UMassIonTrappers/PyOpticL/Designs/modules/scalable_rb_sas/models/rb_cell_holder/rb_cell_holder.stl

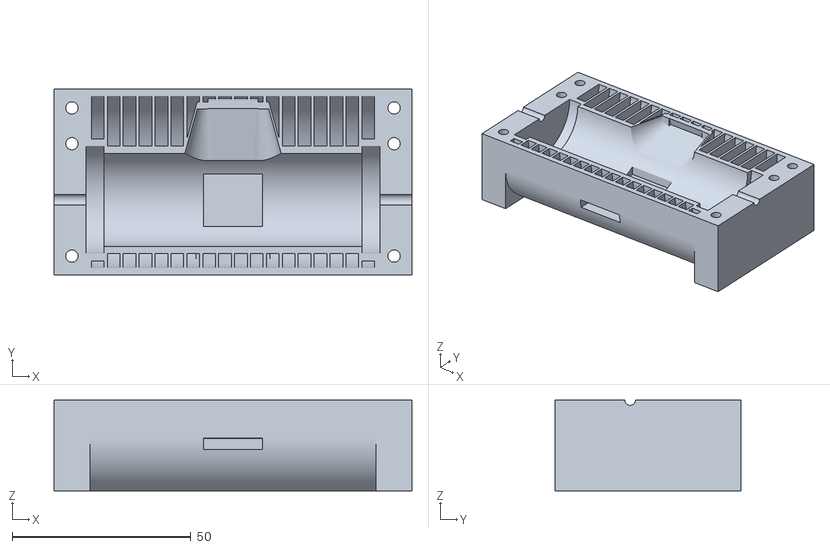
[picture p1: CAD file, 2023-10-21]
Designs/modules/scalable_rb_sas/models/rb_cell_holder/rb_cell_holder.stl
100.0 x 52.0 x 25.4
