UMassIonTrappers/PyOpticL/PyOpticL/models/io-3d-405-pbs/io-3d-405-pbs.step

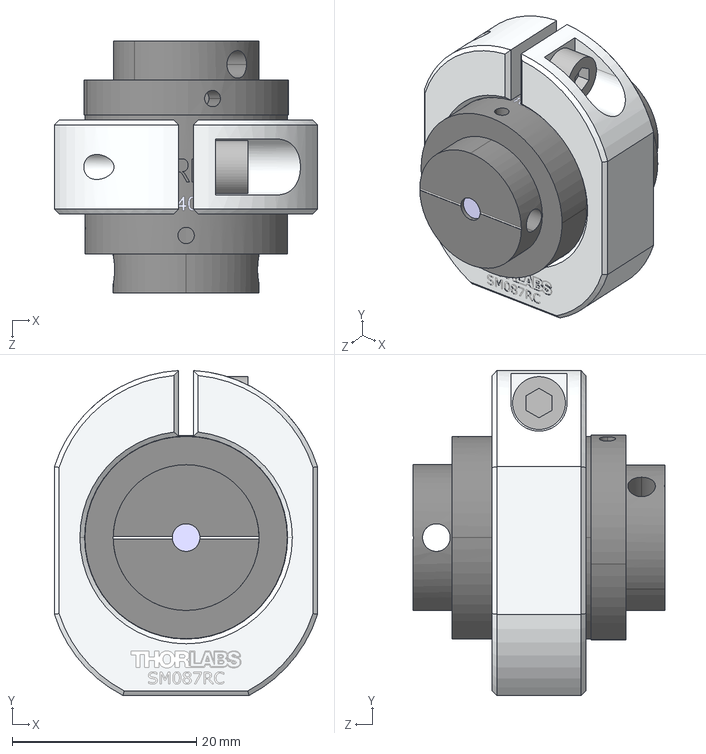
[picture p2: CAD file, 2026-06-15]
PyOpticL/models/io-3d-405-pbs/io-3d-405-pbs.step
28.6 x 35.3 x 27.3 mm
