UMassIonTrappers/PyOpticL/PyOpticL/models/isomet-1205c/isomet-1205c.stl

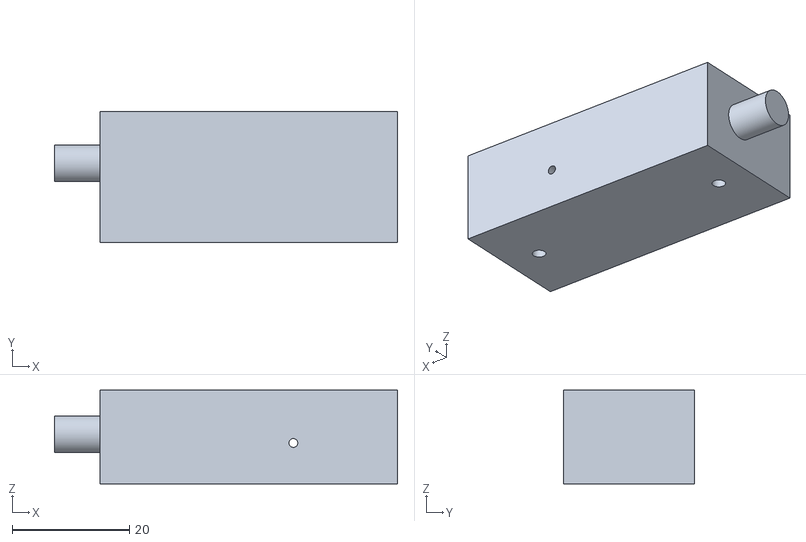
[picture p3: CAD file, 2022-09-13]
PyOpticL/models/isomet-1205c/isomet-1205c.stl
58.6 x 22.3 x 16.0
