UMassIonTrappers/PyOpticL/PyOpticL/models/polaris-b05g/polaris-b05g.step

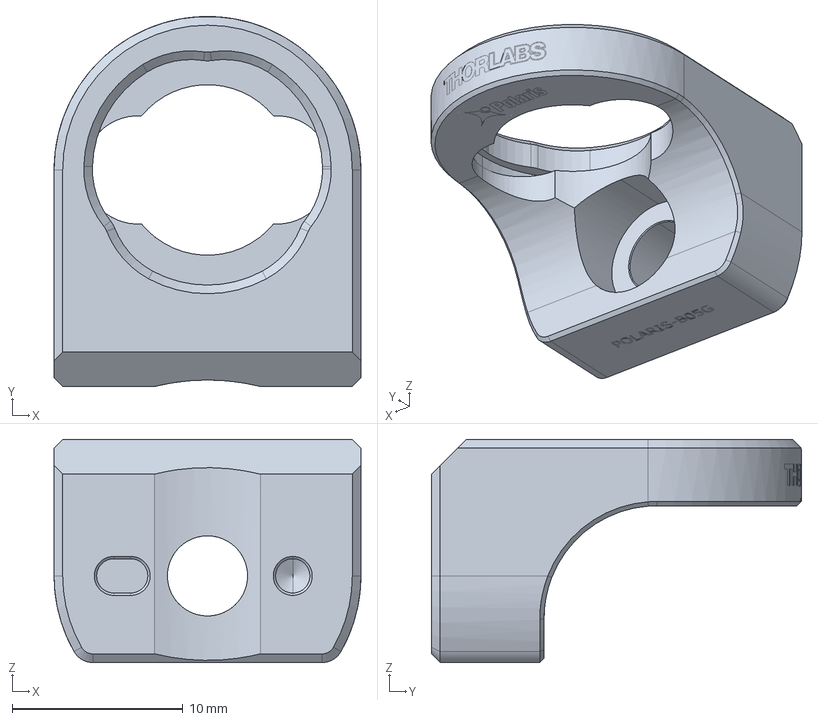
[picture p4: CAD file, 2026-04-15]
PyOpticL/models/polaris-b05g/polaris-b05g.step
18.0 x 21.7 x 13.1 mm
