UMassIonTrappers/PyOpticL/PyOpticL/models/polaris-b1g/polaris-b1g.step

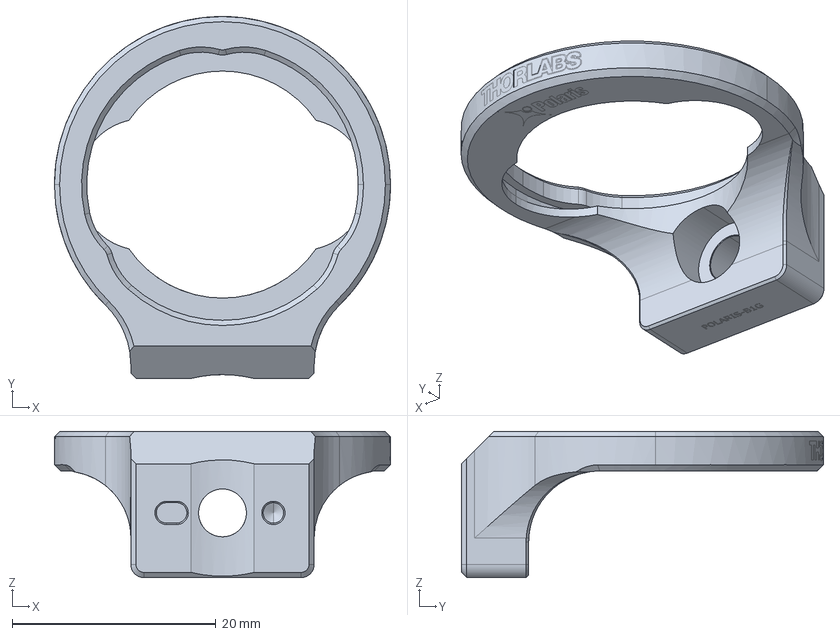
[picture p5: CAD file, 2026-04-26]
PyOpticL/models/polaris-b1g/polaris-b1g.step
33.0 x 35.6 x 14.4 mm
