UMassIonTrappers/PyOpticL/PyOpticL/models/polaris-k05s1/polaris-k05s1.step

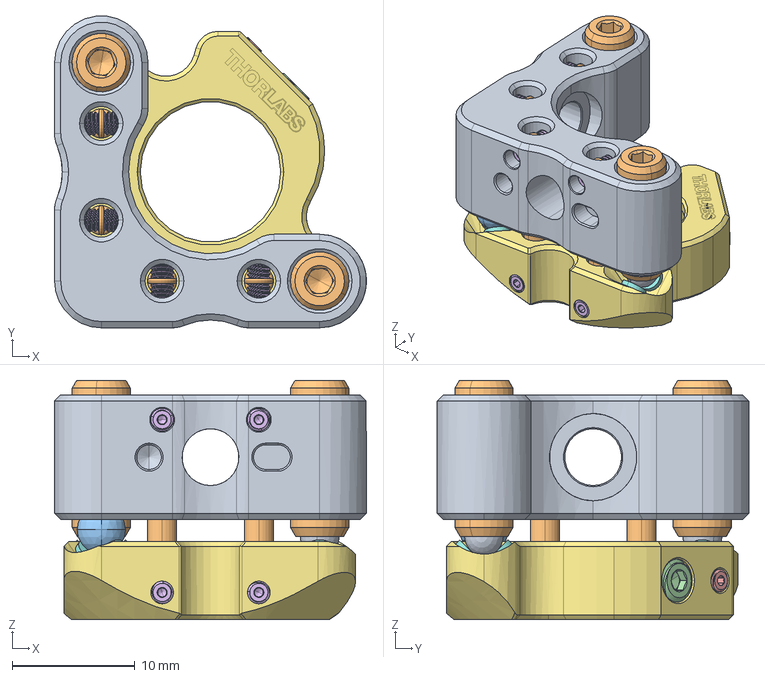
[picture p6: CAD file, 2026-04-14]
PyOpticL/models/polaris-k05s1/polaris-k05s1.step
25.4 x 25.4 x 19.5 mm
