UMassIonTrappers/PyOpticL/PyOpticL/models/polaris-l05g/polaris-l05g.step

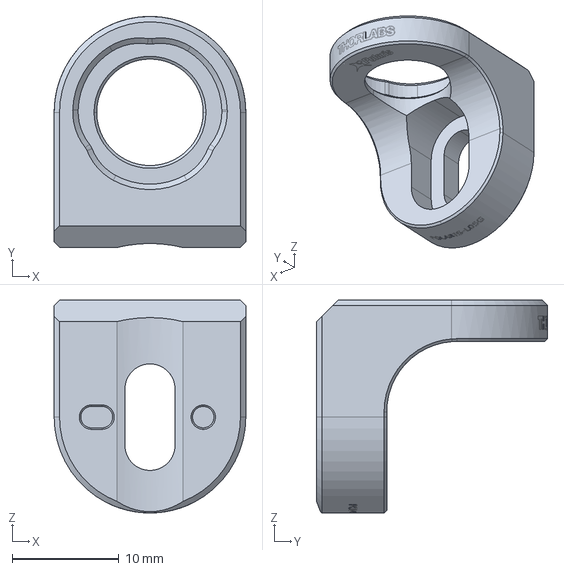
[picture p7: CAD file, 2026-04-15]
PyOpticL/models/polaris-l05g/polaris-l05g.step
18.0 x 21.7 x 20.0 mm
