UMassIonTrappers/PyOpticL/Mod/Optics/freecadOptics/parts/thorlabs/PDA10A2.stl

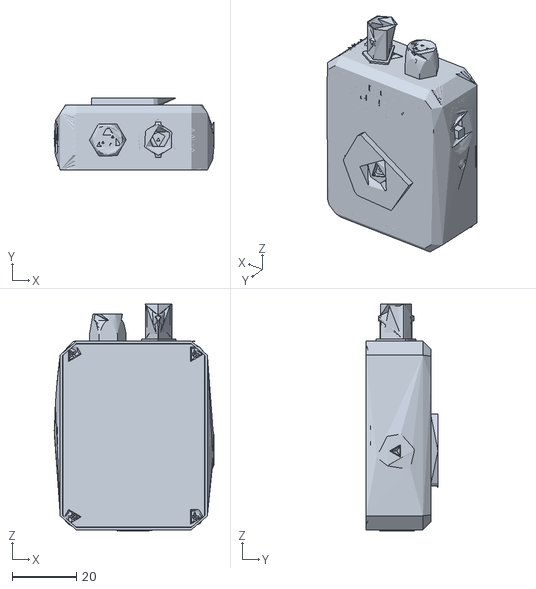
[picture p8: CAD file, 2022-09-13]
Mod/Optics/freecadOptics/parts/thorlabs/PDA10A2.stl
49.9 x 22.5 x 70.9
