UMassIonTrappers/PyOpticL/Mod/Optics/freecadOptics/stl/thorlabs/isomet_1205c_on_km100pm.stl

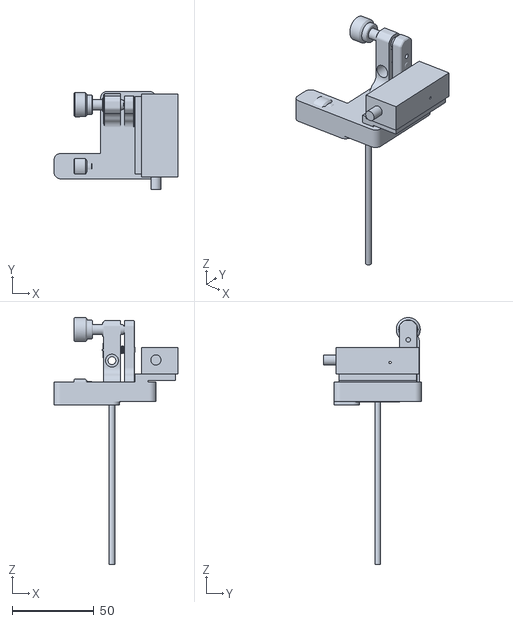
[picture p9: CAD file, 2022-09-13]
Mod/Optics/freecadOptics/stl/thorlabs/isomet_1205c_on_km100pm.stl
75.9 x 60.1 x 151.3
