UMassIonTrappers/PyOpticL/PyOpticL/models/thorlabs-bw20m/thorlabs-bw20m.step

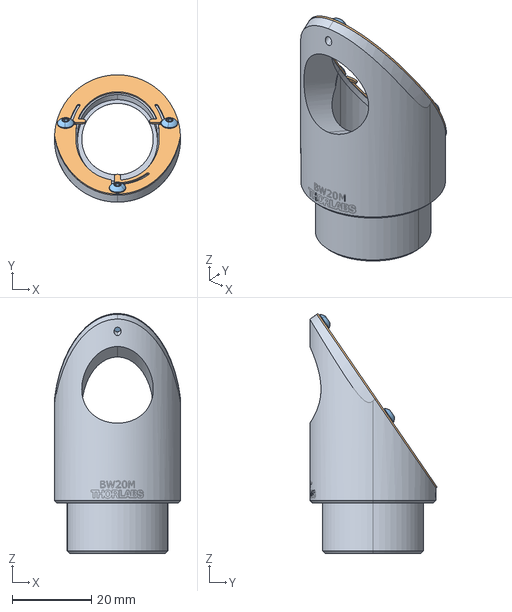
[picture p10: CAD file, 2026-04-26]
PyOpticL/models/thorlabs-bw20m/thorlabs-bw20m.step
31.7 x 32.1 x 60.4 mm
