UMassIonTrappers/PyOpticL/PyOpticL/models/thorlabs-c220tmd-a/thorlabs-c220tmd-a.step

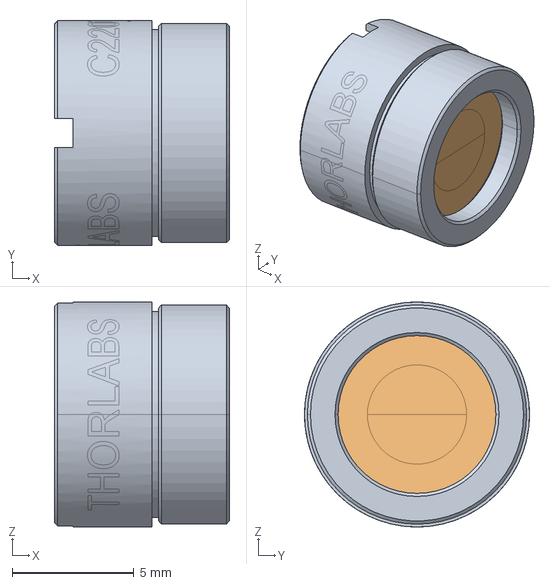
[picture p11: CAD file, 2026-04-26]
PyOpticL/models/thorlabs-c220tmd-a/thorlabs-c220tmd-a.step
7.19 x 9.24 x 9.24 mm
