UMassIonTrappers/PyOpticL/PyOpticL/models/thorlabs-fds010/thorlabs-fds010.step

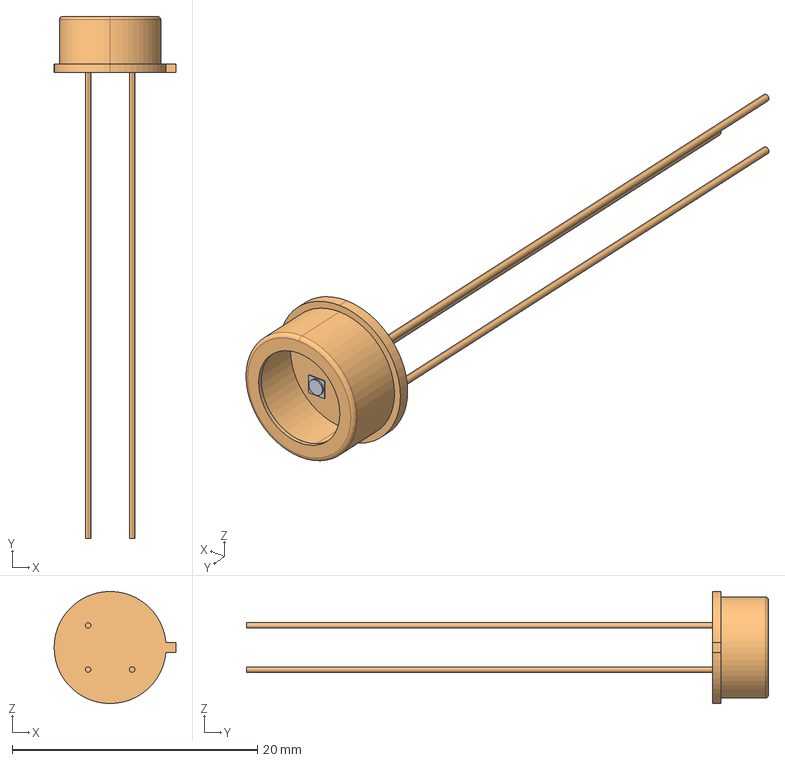
[picture p12: CAD file, 2026-04-21]
PyOpticL/models/thorlabs-fds010/thorlabs-fds010.step
9.94 x 42.6 x 9.14 mm
