UMassIonTrappers/PyOpticL/PyOpticL/models/thorlabs-hca3/thorlabs-hca3.step

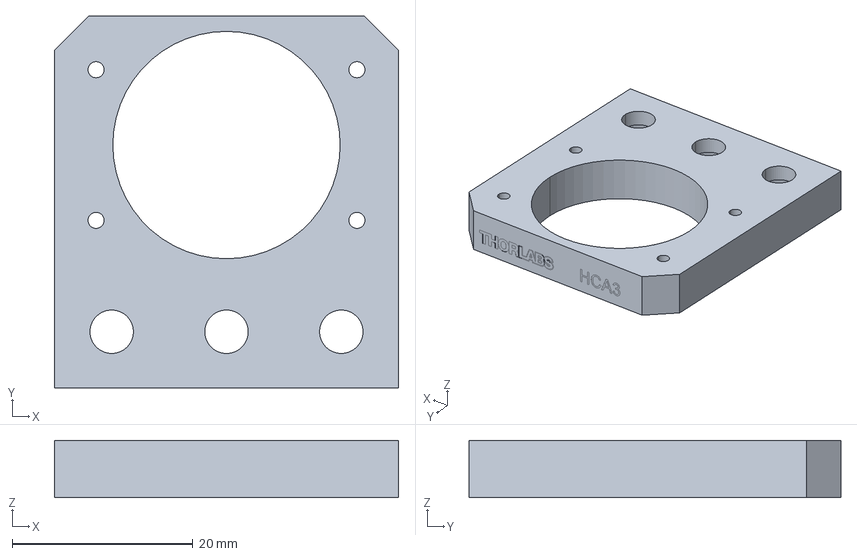
[picture p13: CAD file, 2026-06-13]
PyOpticL/models/thorlabs-hca3/thorlabs-hca3.step
38.1 x 41.1 x 6.35 mm
