UMassIonTrappers/PyOpticL/PyOpticL/models/thorlabs-ida12/thorlabs-ida12.step

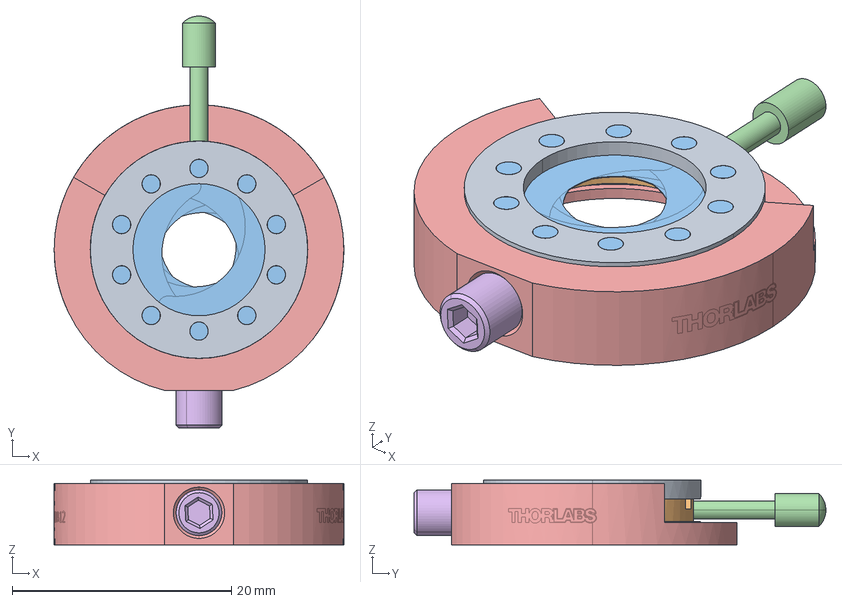
[picture p14: CAD file, 2026-04-27]
PyOpticL/models/thorlabs-ida12/thorlabs-ida12.step
26.4 x 37.6 x 5.89 mm
