UMassIonTrappers/PyOpticL/PyOpticL/models/thorlabs-km05/thorlabs-km05.step

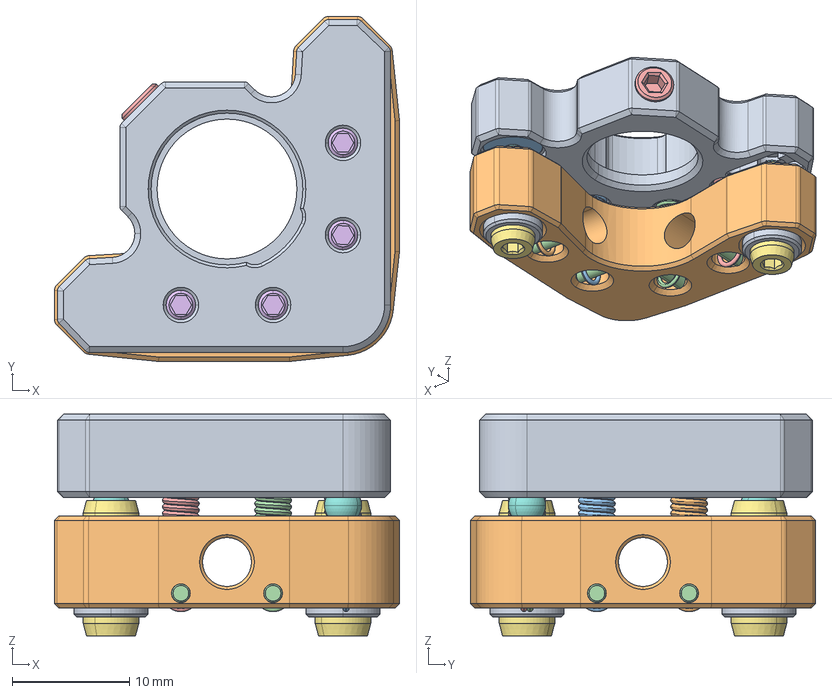
[picture p15: CAD file, 2026-04-26]
PyOpticL/models/thorlabs-km05/thorlabs-km05.step
29.5 x 29.5 x 18.9 mm
