UMassIonTrappers/PyOpticL/PyOpticL/models/thorlabs-km05t/thorlabs-km05t.step

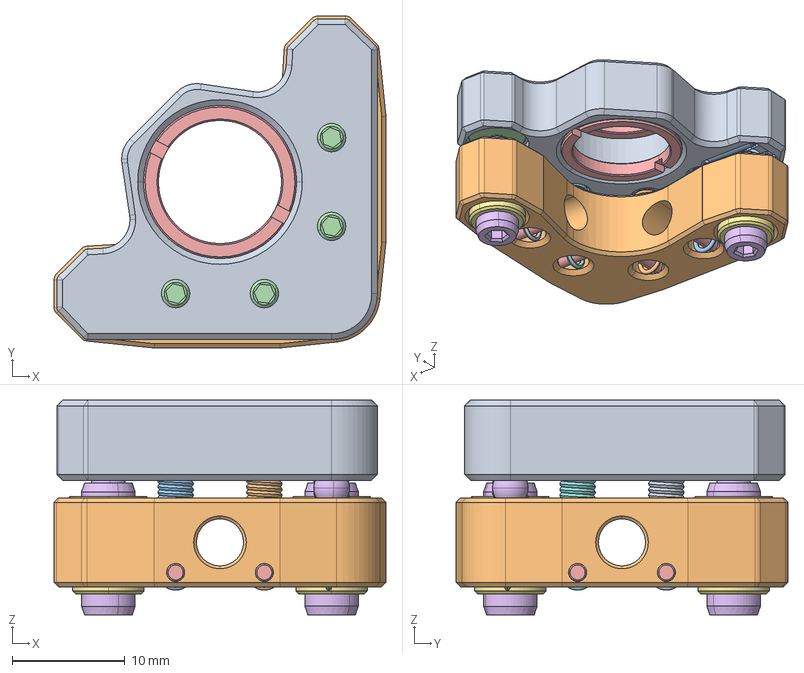
[picture p16: CAD file, 2026-04-26]
PyOpticL/models/thorlabs-km05t/thorlabs-km05t.step
29.5 x 29.5 x 19.1 mm
