UMassIonTrappers/PyOpticL/PyOpticL/models/thorlabs-km100/thorlabs-km100.step

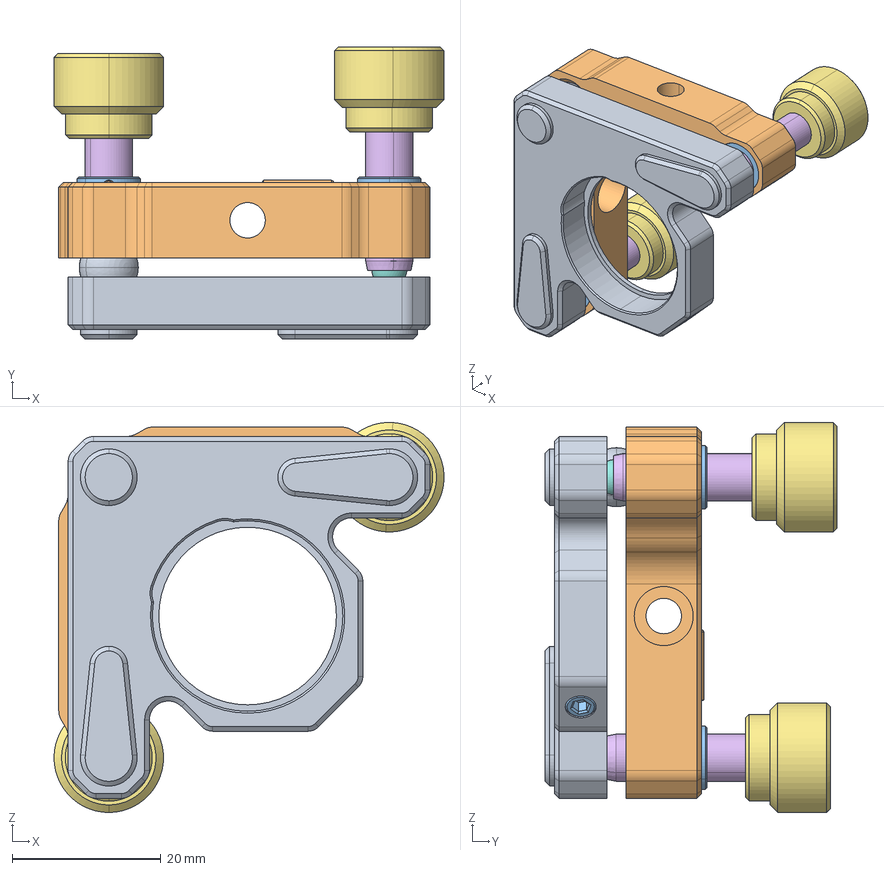
[picture p17: CAD file, 2026-04-21]
PyOpticL/models/thorlabs-km100/thorlabs-km100.step
52.4 x 39.3 x 52.4 mm
