UMassIonTrappers/PyOpticL/PyOpticL/models/thorlabs-km100pm-noplatform/thorlabs-km100pm-noplatform.step

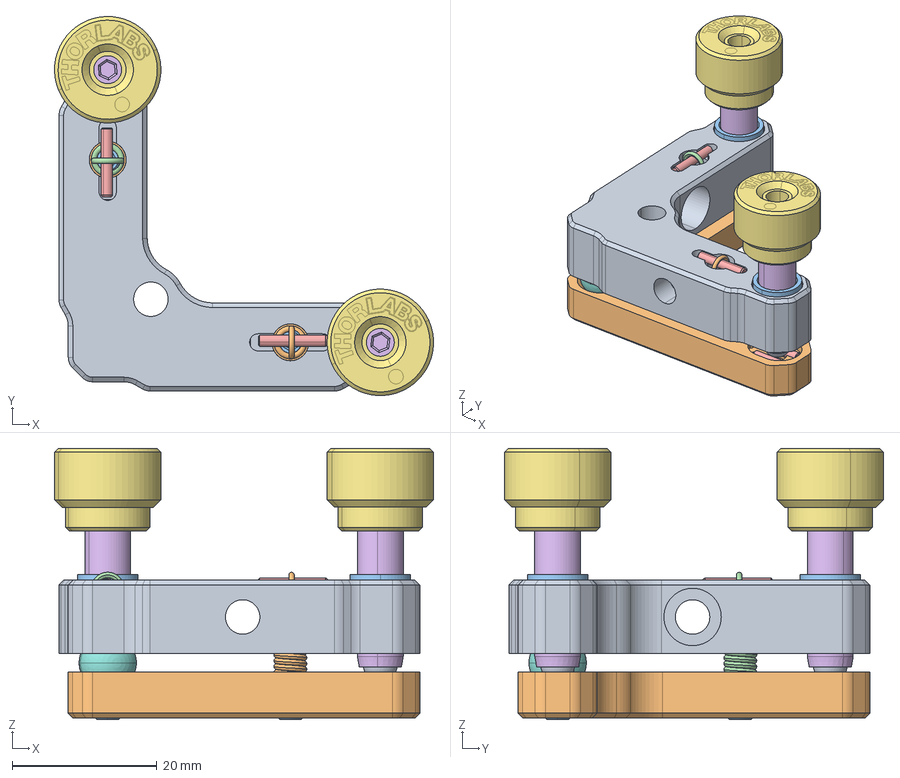
[picture p18: CAD file, 2026-04-26]
PyOpticL/models/thorlabs-km100pm-noplatform/thorlabs-km100pm-noplatform.step
52.4 x 52.4 x 37.5 mm
