UMassIonTrappers/PyOpticL/(list of files, cad)

Other CAD files:
PyOpticL/models/thorlabs-s05lm56/thorlabs-s05lm56.step
PyOpticL/models/thorlabs-s05tm09/thorlabs-s05tm09.step
PyOpticL/models/thorlabs-s1tm09/thorlabs-s1tm09.step
PyOpticL/models/thorlabs-sm05l05/thorlabs-sm05l05.step
PyOpticL/models/thorlabs-sm1fca2/thorlabs-sm1fca2.step
PyOpticL/models/thorlabs-smr05/thorlabs-smr05.step
PyOpticL/models/thorlabs-tech8/thorlabs-tech8.step
