UMassIonTrappers/PyOpticL/(threads)

Thread 7 (2025-01-26):

Optics Vendors

UMassIonTrappers, 2025-01-26:
Many other optics vendors can be added to the library.
Not only for the mechanical mounts (Newport) for also for the optics themselves (CN-optics).
Would be nice to have a way to specify all of the optics by part number for all systems and create a 'bill of materials'.

Jyers, 2025-01-31:
This already exists to some extent. All off-the-shelf mounts and components in the library should have a part number defined. Further, any optics such as mirrors, splitters, lenses, etc. have a part number parameter which can be specified when placed. This is how the export to Thorlabs cart works and could be pretty easily expanded to a more general BOM.

Jyers, 2025-01-31:
Yes, I think generating a BOM with the CAD drawings would be good. FreeCAD might already have some templates for that. I'll look into it.

Thread 8 (2025-01-29):

Not rendering

laserroger, 2025-01-29:
Tried the example on both a Mac and a PC but after executing the Macro .py file nothing happened in the FreeCAD.

UMassIonTrappers, 2025-01-29:
Thank you for reaching out!
After starting FreeCAD and before loading macro files, did you create a new document window?
We are not exactly sure what was going on in your end. If more description is provided, it could be more helpful.

Also, we are updating our quick start guide for less misunderstanding. Let us know if there are any problems.

UMassIonTrappers, 2025-01-29:
Launch FreeCAD and open a new document:
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

Navigate to "Macro" > "Macros ..."
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

Select the location of your script in the "User macros location:" bar
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

Now select your script in the list and hit "Execute"!
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

Once you've run your script once it will then also appear in the "Macro" > "Recent macros" drop down list
Or you can re-run your last macro with Ctrl-Shift-1

**Congratulations! You're ready to start making your own layouts in PyOptic, so get making!**

laserroger, 2025-01-29:
I recorded what I did (note I also tried directly switch to PyOpticL before loading the macro, the same result)

https://github.com/user-attachments/assets/bd2d97e8-37f0-42c6-95db-97ea39893d83

laserroger, 2025-01-29:
NVM, I realized the problem is the example you provided here: https://github.com/UMassIonTrappers/PyOpticL/wiki#quickstart-guide

it's imported from `PyOptic` while it should be `PyOpticL`

UMassIonTrappers, 2025-01-30:
Sorry for that typo! We've revised the examples to properly import PyOpticL.

Closed 2025-01-29.

Thread 10 (2025-01-30):

fiberport_mount_hca3's drill is conflicting with the baseplate

laserroger, 2025-01-30:
Minimal working example
```
from PyOpticL import layout, optomech
from datetime import datetime

# Adding name and date to keep a track of the updates
name = "Test"
date_time = datetime.now().strftime("%m/%d/%Y")
label = name + " " +  date_time

# Dimension of the baseplate
base_dx = 5*layout.inch
base_dy = 5*layout.inch
base_dz = layout.inch
gap = layout.inch/8

mount_holes = [(0,0), (0,4), (4,0), (4,4)]

# Combining the baseplate with the beam and all other optical components.
def Test(x=0, y=0, angle=0, mirror=optomech.mirror_mount_km05, thumbscrews=True):

    # Difining the baseplate
    baseplate = layout.baseplate(base_dx, base_dy, base_dz, x=x, y=y, angle=angle,
                                 gap=gap, name=name, label=label, mount_holes=mount_holes, x_splits=[0*layout.inch, 0*layout.inch])

    # Adding the beams to the baseplate
    beam = baseplate.add_beam_path(x=base_dx - 2*layout.inch, y=0, angle=90)

    baseplate.place_element("Input Fiberport", optomech.fiberport_mount_hca3, x = base_dx - 2*layout.inch, y=0, angle=layout.cardinal['up'], drill=False)

    ## Adding two mirrors to give the beam enough degree of freedom. Mirror 1
    baseplate.place_element_along_beam("Input Mirror 1", optomech.circular_mirror, beam,
                                       beam_index=0b1, distance=1*layout.inch, angle=layout.turn['up-left'],
                                       mount_type=mirror, mount_args=dict(thumbscrews=thumbscrews))

    # Miror 2
    baseplate.place_element_along_beam("Input Mirror 2", optomech.circular_mirror, beam,
                                       beam_index=0b1, distance=1*layout.inch, angle=layout.turn['up-right'],
                                       mount_type=mirror, mount_args=dict(thumbscrews=thumbscrews))

if __name__ == "__main__":
    Test()
    layout.redraw()
```

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

If the fiber port has `drill=True` then it will generate
`Null input shape, Internal name: Test`
warning and the rendered result also doesn't contain the plate
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

laserroger, 2025-01-30:
> I've seen this error pop up before after having upgraded to the newest FreeCAD version.
Thanks very useful knowledge; what's the version you were using?

Jyers, 2025-01-31:
Much of our testing was done on FreeCAD version 0.20, however from my limited testing with FreeCAD 1.0, this is the only error I've encountered thus far.

I looked into it and found there was another underlying change to how FreeCAD handles shapes in 1.0 which happened to only break the fiberport drilling because of how it was computed. I believe I've fixed it with 0dd3585. Let me know if the issue persists.

laserroger, 2025-02-02:
Seems fixed now; thanks!

Closed 2025-02-02.

Thread 9 (2025-01-30):

Missing the vapor cell model?

UMassIonTrappers, 2025-01-30:
Where is the model for the high temp resin holder for the vapor cell in the SAS plate?

UMassIonTrappers, 2025-02-03:
https://github.com/UMassIonTrappers/PyOpticL/wiki/Module-%E2%80%90-Saturation-Absoption-Spectroscopy-Baseplate
Good point. Already add relevant information in wiki!

Closed 2025-02-03.
