UMassIonTrappers/PyOpticL/(commit log)

2022-09-21 Reformatting of Repo
    [ADABS3-Step.stl, BA1-Solidworks.stl, CP02-Solidworks.STL, CP33-1.STL, CP33.STL, D5S-Solidworks.stl, DMM05-Solidworks.STL, FBR-AQ1-Solidworks.stl]
2022-09-22 Add Mount Point Bolt
2022-10-12 Move modules into workbench dir
    [ADABS3-Step.stl, BA1-Solidworks.stl, CP02-Solidworks.STL, CP33-1.STL, CP33.STL, D5S-Solidworks.stl, DMM05-Solidworks.STL, FBR-AQ1-Solidworks.stl]
2022-10-21 Moving stuff around
    [ADABS3-Step.stl, BA1-Solidworks.stl, CP02-Solidworks.STL, CP33-1.STL, CP33.STL, D5S-Solidworks.stl, DMM05-Solidworks.STL, FBR-AQ1-Solidworks.stl]
2022-12-03 Fixed inline edge case and added new constraints
2023-03-03 Moved stls
    [ADABS3-Step.stl, BA1-Solidworks.stl, CP02-Solidworks.STL, CP33-1.STL, CP33.STL, D5S-Solidworks.stl, DMM05-Solidworks.STL, FBR-AQ1-Solidworks.stl]
2023-03-08 Universal Mirror Mounts
2023-03-15 Modular doublepass base plate with updated AOM mount to be opposite direction of input
2023-03-16 Longer minimum laser length to see diffraction orders from AOM
2023-03-17 Laser Bugfix
2023-03-18 Larger drill holes for baseplate mount
2023-03-18 example STL file
    [Modular_Doublepass_Baseplate.stl]
2023-03-18 super small version for resin printer
2023-03-18 Moving to 'stl' folder
    [Modular_Doublepass_Baseplate.stl]
2023-03-18 Autogenerating STL files and exporting to dedicated folder
    [baseplate_modular_doublepass.stl, baseplate_modular_doublepass_resin.stl, baseplate_modular_noise_eater.stl]
2023-03-18 Set view and export stl
2023-03-18 Set splitter mount 'mirror' thickness to zero... need to properly account for thickness of splitter though and allow beam to pass through mount
2023-03-19 Correct plate thickness for splitter mount c05g
2023-03-24 updated width so beam is 1inch offset from bolts
2023-03-24 Images of doublepass
    Added images of double pass plate with laser light going through it
2023-03-25 part numbers and km05 mounts
2023-03-25 Removed auto stl export
2023-03-25 Use GUI to export STL instead
    [baseplate_modular_doublepass.stl, baseplate_modular_doublepass_resin.stl, baseplate_modular_noise_eater.stl]
2023-03-26 New STL models for ECDL
    [AD15NT.stl, GH13-24V.stl, IOT-5-670-VLP.stl, ISO-04-650-LP.stl, LT230P-B.stl]
2023-03-28 Added direct mounting for KM05
2023-03-30 Update README.md
    Added new photo of two plates side by side.
2023-04-06 Finish AOM Mount
2023-04-06 Fix isolator_670 Drilling
2023-04-06 Move Drill Placement to Baseplate Function
2023-04-17 Much better laser part handling
2023-04-20 AOM Drill Fix
2023-04-22 Laser Draw Order Edge Case Fix
2023-04-22 Extra room for AOM Connector
2023-06-30 added cylinder to km05 to visualize length of laser
2023-07-01 km05 laser visual changed reflection to transmission
2023-07-06 added cavity for adjustment knob to km05 mounts
2023-07-07 knob cavity 2mm longer
2023-07-08 Updated km05 fiberport and laser mount limit parameters
2023-10-04 Laser Drilling
2023-10-15 Mounting Holes
2023-10-20 Added Rb Cell
    [rb_cell_holder_middle.stl]
2023-10-26 Added Mount Invert Option to Rotation Stage
2023-10-26 Added PDA10A2.stl
2023-10-27 Limit laser to baseplate bounds
2023-10-27 Rename Folders
    [AD15NT.stl, ADABS3-Step.stl, BA1-Solidworks.stl, CP02-Solidworks.STL, CP33-1.STL, CP33.STL, D5S-Solidworks.stl, DMM05-Solidworks.STL]
2023-10-27 Isolating Repo to Workbench Folder
    [AD15NT.stl, ADABS3-Step.stl, BA1-Solidworks.stl, CP02-Solidworks.STL, CP33-1.STL, CP33.STL, D5S-Solidworks.stl, DMM05-Solidworks.STL]
2023-10-30 Fixed l05g lens mount
2023-11-03 New GUI Functions and Some Cleanup
    [POLARIS-K05S1-Step.stl]
2023-11-08 Base all STL Imports on Thorlabs STEP Files
    [AD15NT.stl, ADABS3-Step.stl, BA1-Solidworks.stl, CP02-Solidworks.STL, CP33-1.STL, CP33.STL, D5S-Solidworks.stl, DMM05-Solidworks.STL]
2023-11-08 Fixed STL Export Function
2023-11-11 Laser Cleanup
2023-11-12 Added HKTS STL
    [HKTS-5_64-Step.stl]
2023-11-12 Drilling Changes and General Cleanup
2023-11-13 Remove Splitters in Baseplate after Drilling
2023-11-13 Updated KM05 Fiberport to Use Real Modeled Parts
    [C220TMD-A-Step.stl, S05TM09-Step.stl, SM05FCA2-Step.stl, SM05L05-Step.stl]
2023-11-14 Added Comonents for KS1T Fiberport Mount
    [S1TM09-Step.stl, SM1FCA2-Step.stl, SM1L05-Step.stl]
2023-11-14 Added Components for KM05 Laser Mount
    [S05LM56-Step.stl, SM05L05-Step.stl]
2023-11-15 Fixed Baseplate Placement for Drilling
2023-11-29 Added Lens Tube to Photodiode
    [SM1L03-Step.stl]
2023-11-29 Rb Cell Drilling Change
2023-12-01 Added KM05PM and Grating Mount
2023-12-01 Added Linear Mount
2023-12-11 Rough Mount-Fix Changes
2023-12-11 Fix Grating Mount Constraints
2023-12-12 Fixing Thumbscrew Drilling
2024-02-13 Rough Chamber Additions
2024-04-05 Added Cylindrical Lenses
2024-05-10 Finish Rename #2
    [C220TMD-A-Step.stl, HCA3-Step.stl, HKTS-5_64-Step.stl, IDA12-P5-Step.stl, IO-3D-405-PBS-Step.stl, IOT-5-670-VLP-Step.stl, KM100PM-Step.stl, MK05-Step.stl]
2024-05-13 Improved Laser Cavity Mount Start
    [MLH05-Step.stl, SMR05-Step.stl]
2024-05-15 New Laser Mount
2024-05-16 Added laser_mount_km100pm
2024-05-17 Improved grating mount
2024-05-17 Box for km100pm laser
2024-05-17 Improved km100pm laser
2024-06-12 chenge for redstone stuff
    [KMSS_MH12_step.stl, KMSS_step.stl, MH12_step.stl, TEC.stl, grid_beamsplitter_lying_down_baseplate.stl, grid_beamsplitter_lying_down_baseplate_mount.stl, grid_mirror_lying_down_baseplate.stl, grid_waveplate_lying_down_baseplate.stl]
2024-06-18 update redstone
    [baseplate_for_periscope_redstone.stl, periscope_for_redstone.stl]
2024-07-24 reworked mount and optic structure
2024-07-27 New bolt object, and drilling for baseplates
2024-07-29 Move mount placement to base optic
2024-08-05 add cutbox and fix a few bolt things
2024-08-05 big mount restructure and fixes
2024-08-05 fix baseplate drilling
2024-08-05 mounts for redstone
2025-11-14 Initial Framework and Testing Examples
2025-11-20 Overhaul mesh model handling
    [polaris-k05s1.step]
2025-11-20 Add alignment pin and cleanup
2026-01-16 Switch from geometric to gaussian beam modeling
2026-01-20 Implement refraction in circular_reflector (#15)
    * Implement refraction in beamsplitter
    * correct interface offset and example
    * Formatting and error printout
    * Add rounded end-caps to beams to mitigate gaps at junctions
    * Formatting
    ---------
2026-04-13 Implement global settings, improve bolt component, and adjust inline constraint handling
2026-04-13 Dynamic to-surface drilling and surface adapter updates
2026-04-14 Preserve model library transformations and utils cleanup
    [polaris-k05s1.step]
2026-04-14 Improve drilling
2026-04-14 Limit drilling by group
2026-04-14 Fix rotation of cylinder shape
2026-04-15 Cleanup and additions
    [polaris-b05g.step, polaris-l05g.step]
2026-04-21 Cleanup and minor fixes
    [C220TMD-A-Step.stl, HCA3-Step.stl, HKTS-5_64-Step.stl, IDA12-P5-Step.stl, IO-3D-405-PBS-Step.stl, IOT-5-670-VLP-Step.stl, KM100PM-Step.stl, KMSS_MH12_step.stl]
2026-04-21 Setting up scalable Rb SAS plate and general fixes
    [thorlabs-fds010.step, thorlabs-km100.step]
2026-04-26 Finishing up scalable Rb SAS example
    [polaris-b1g.step]
2026-04-26 Updates and design work
    [thorlabs-c220tmd-a.step, thorlabs-km05.step, thorlabs-km05t.step, thorlabs-km100pm-noplatform.step, thorlabs-s05lm56.step, thorlabs-s05tm09.step, thorlabs-sm05l05.step, thorlabs-smr05.step]
2026-04-26 Port ECDL design
    [thorlabs-bw20m.step, thorlabs-tech8.step]
2026-04-27 Add isomet 1205c and adapter
    [isomet-1205c.stl]
2026-04-27 Add doublepass, singlepass, and laser cooling subsystem
    [thorlabs-ida12.step]
2026-04-28 Fix drill surface rotation
2026-06-09 Update laser_cooling_subsystem.py
    formatting
2026-06-13 Add HCA3 and PAF2 fiberport parts
    [thorlabs-hca3.step]
2026-06-14 Update designs
    [rb_cell_holder.stl]
2026-06-15 keep migrating from old design. add 1) telescope 2) periscope 3) isolator plate 4)beam pick off
    [io-3d-405-pbs.step, thorlabs-s1tm09.step, thorlabs-sm1fca2.step]
2026-06-15 update laser_cooling_system with isolator plate (updated) and transparent ECDL box
2026-06-16 Organize designs
    [rb_cell_holder.stl]
